old789/UPS/README.md

# UPS
 An emergency power source for power outages.
 
 A control module built on the Arduino Nano.

 Використовує LiFePo батарею, потужний інвертор та високострумовий зарядний пристрій.
 В інвертор додана ланка для віддаленого керування.
