old789/UPS/emergency_power_supply_schm.jpg

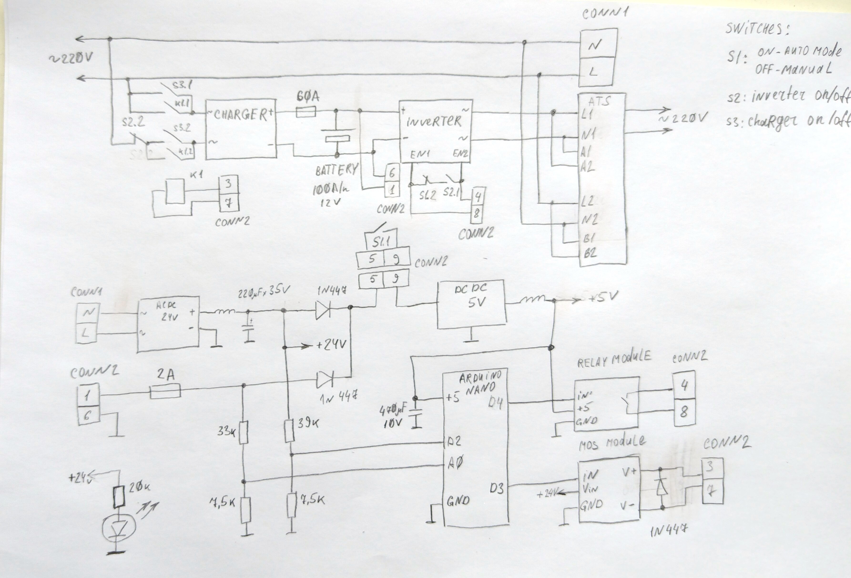
emergency_power_supply_schm.jpg
