old789/UPS/(commit log)

2023-05-26 Update UPS.ino
    The reset of a watchdog timer moved to a more appropriate place.
    [UPS.ino]
2023-05-26 Create emergency_power_supply_schm.jpg
    added a schematic diagram
2024-06-18 Charge longer time
    There is unexpected trouble: after discharge more then 50%, battery don't fully charge
2024-07-09 fix incorrect pin number
2024-09-21 buttons (unsuccessful)
2024-09-23 reaction to press button
    probably incorrect, but works
2024-09-24 1st stage
2024-09-24 2nd stage
2024-09-25 two mode on one button
2024-09-26 adding current sensor
2024-09-27 delay after charger current off
